joneschmidt/ApproachIndicator/README.md

# ApproachIndicator
Arduio code and docs related to the Approach Indicator model rr project

Direction based sensing to announce the approach of a model train to a town/tower.

HitTheBell.pdf is a presentation I did on this project at the PCR NMRA 2022 conference.
