joneschmidt/ApproachIndicator/ApproachIndicatorSchematic.pdf

Approach Indicator 4.5

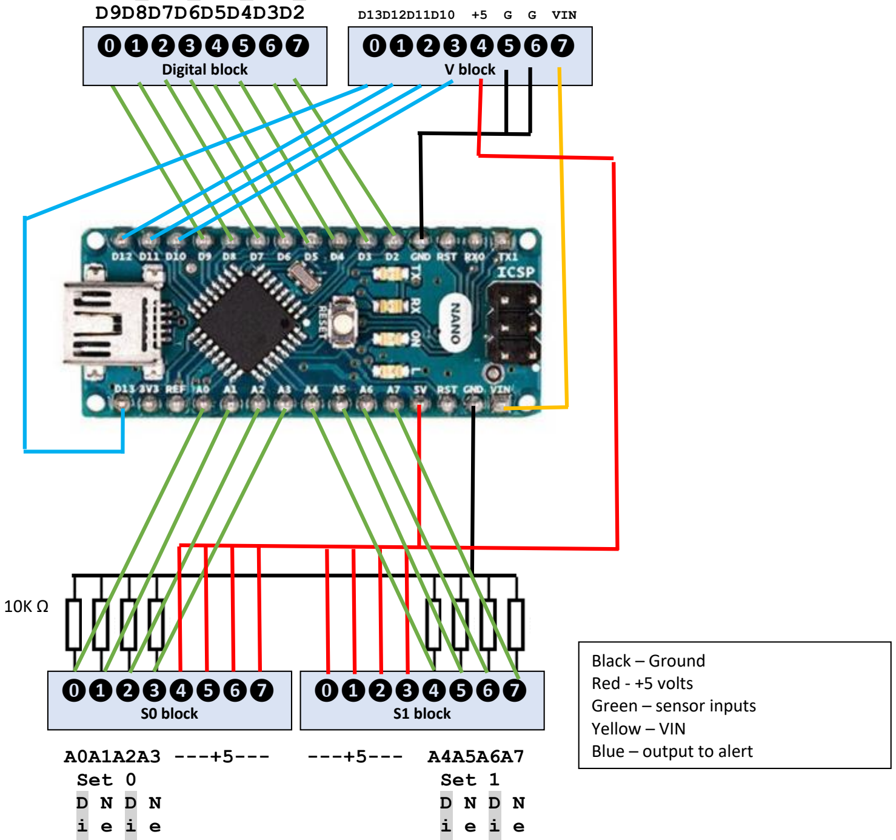
[picture p1: figure]
VIN; Set 0; Set 1; ⓿❶❷❸❹❺❻❼; S1 block; S0 block; V block; Digital block; Black – Ground Red - +5 volts Green – sensor inputs Yellow – VIN Blue – output to alert

10/30/2021 12:48 PM

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

Approach Indicator 4.5

10/30/2021 12:48 PM

Relay board:

Com | Common
NC | Normally closed
NO | Normally open
C | | C
- N | N | o N | N
m C | O | m C | O
LED | LED
S | S
e | e | G
t | t | n
0 | 1 | d

## ⓿❶❷❸

S0 block

## ⓿❶❷❸

S1 block

## ⓿❶❷❸

Input block
