joneschmidt/ApproachIndicator/(commit log)

2021-10-10 Add files via upload
    The 2 zip files contain the 2 .ino arduino files
2021-10-10 Added schematic and later version of AI.docx
